galmchd92/Smart-Meter-using-ESP32-LoRa-Heltec/Layouts .pdf

# Layouts do circuito impresso

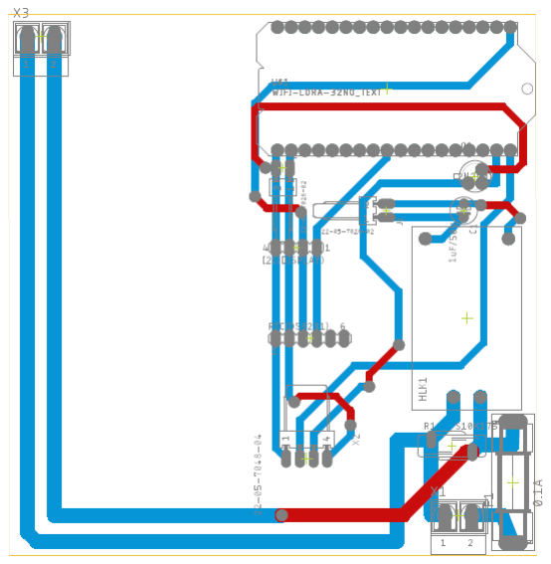
[picture p1: figure]

Figura 1 - Layout da placa feito no software Eagle

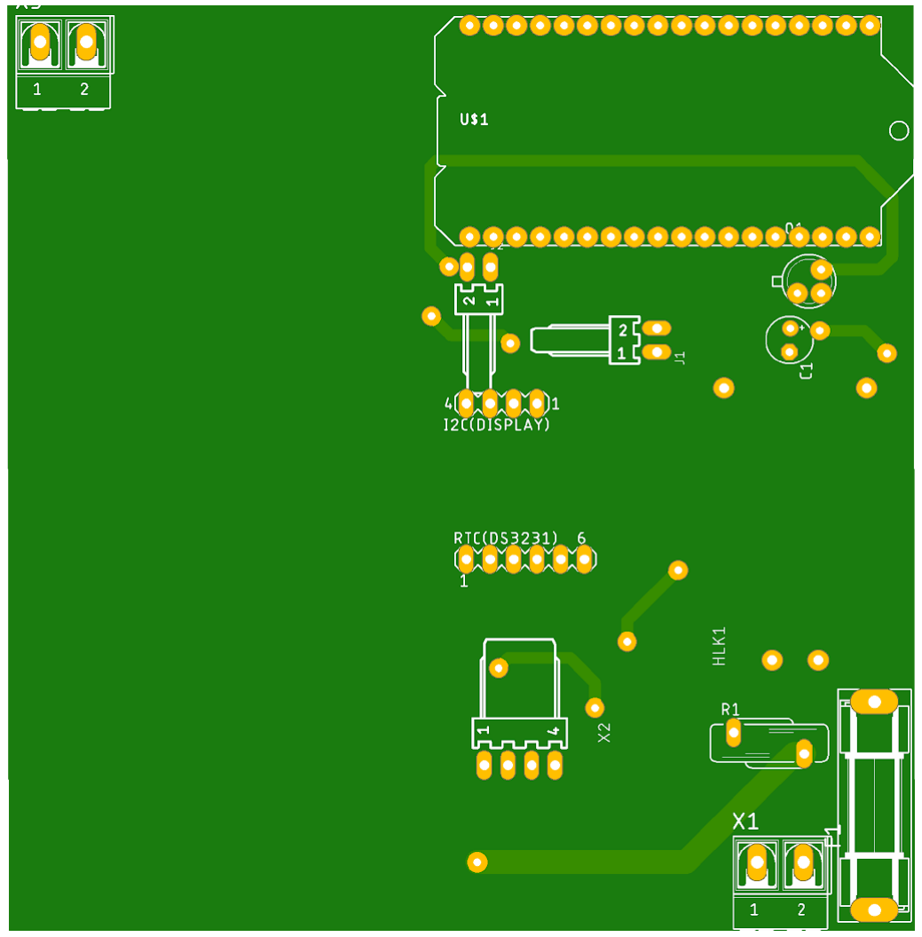
[picture p2: figure]

Figura 2 - Top

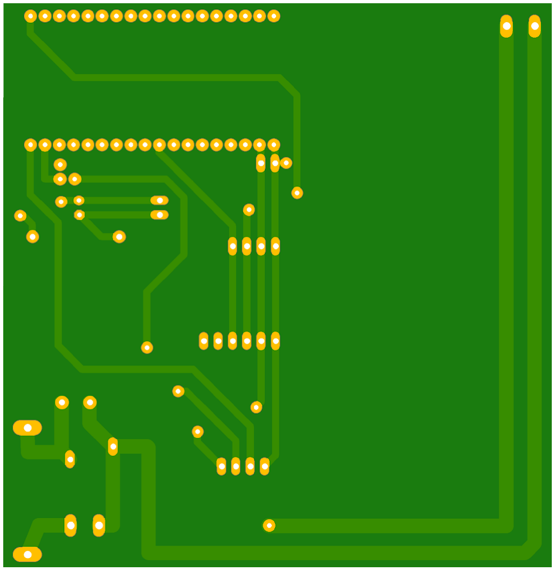
[picture p3: figure]

Figura 3 - Bottom

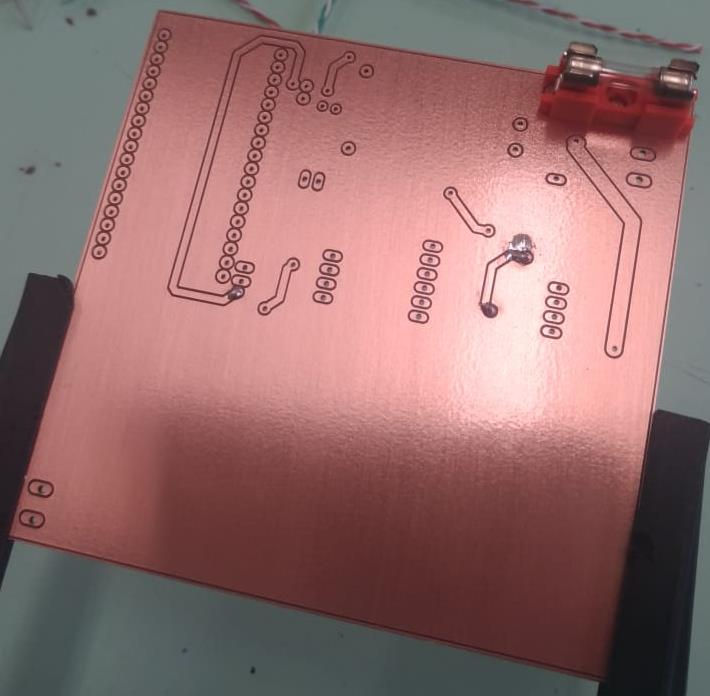
[picture p4: figure]

Figura 4 - Início do trabalho de soldagem

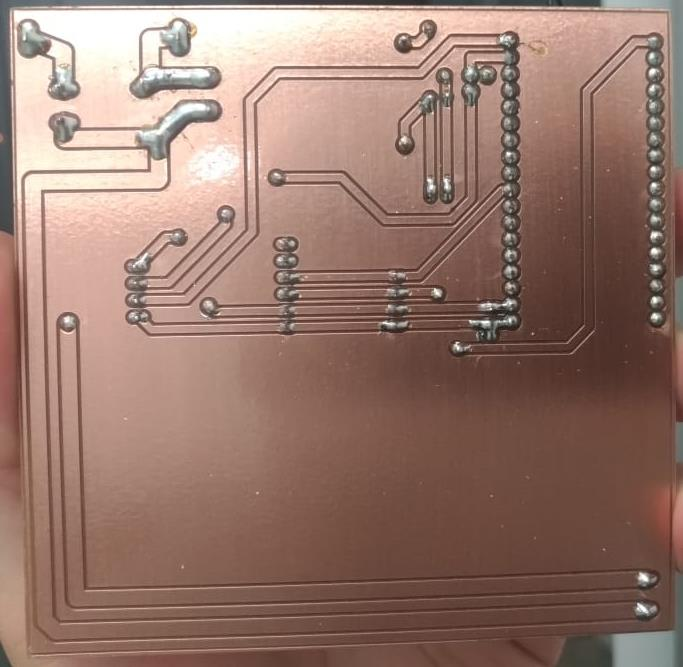
[picture p5: figure]

Figura 5 - Fim do trabalho de soldagem

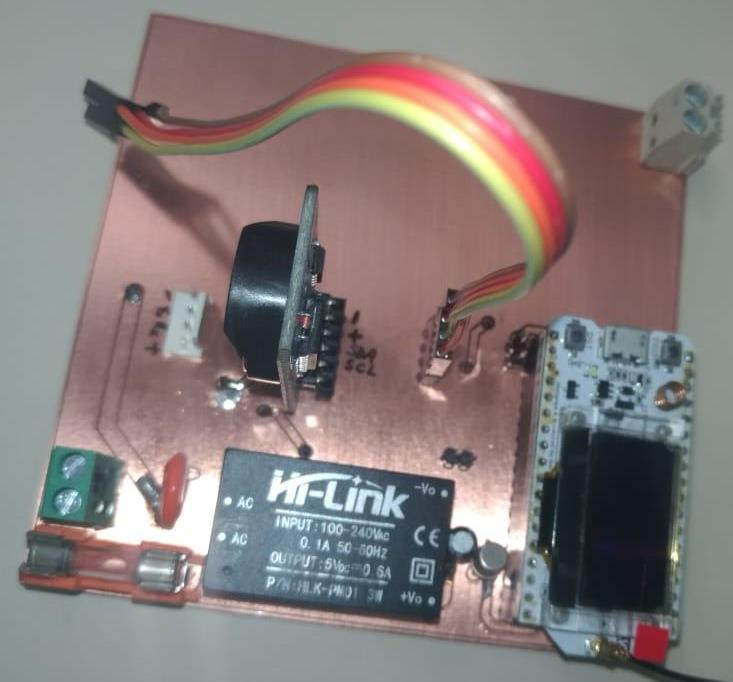
[picture p6: figure]

Figura 6 - Placa com seus devidos componente fixados

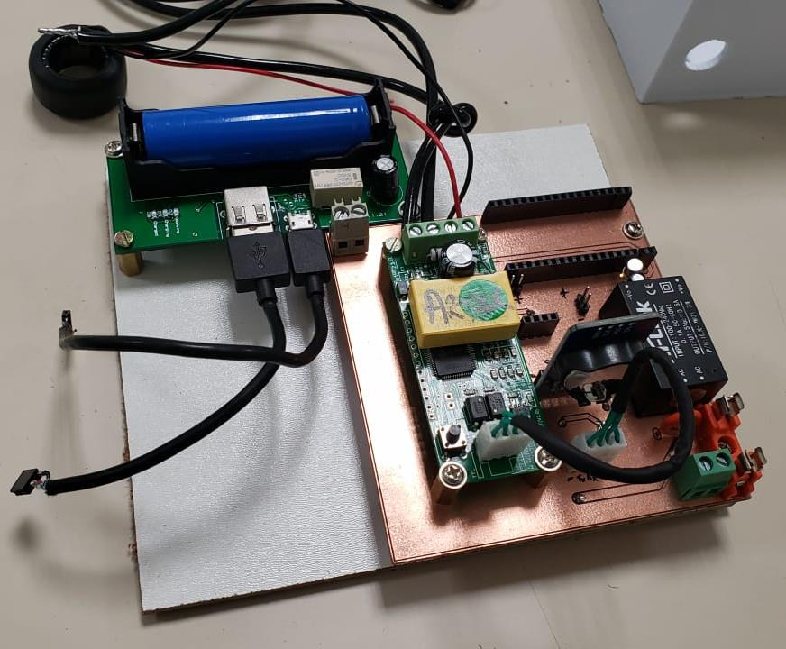
[picture p7: figure]

Figura 7 - Placa finalizada fixada numa placa de madeira com o nobreak
