galmchd92/Smart-Meter-using-ESP32-LoRa-Heltec/PDF Diagrama de Fiação.pdf

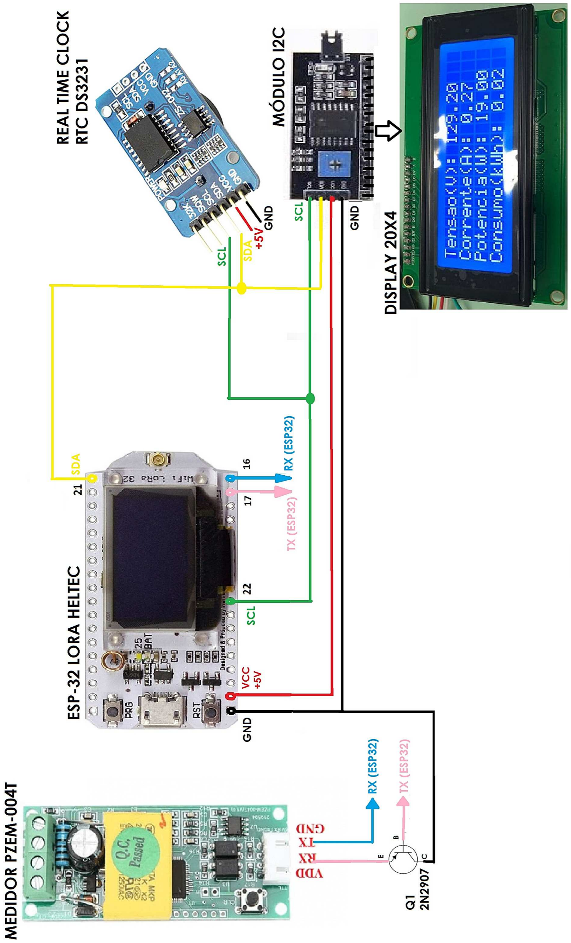
[picture p8: page 1]
