galmchd92/Smart-Meter-using-ESP32-LoRa-Heltec/Blynk App Tcc.jpg

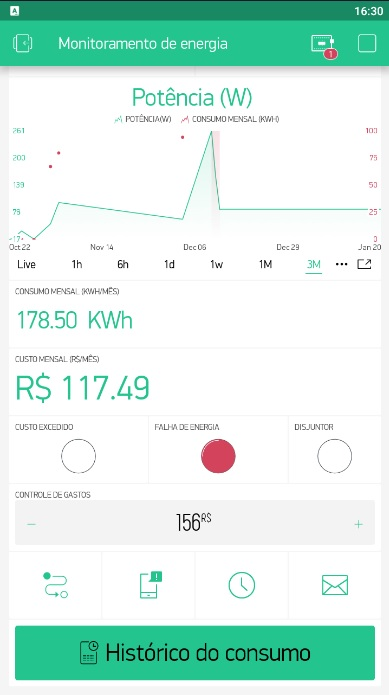
Blynk App Tcc.jpg
