galmchd92/Smart-Meter-using-ESP32-LoRa-Heltec/tcc_v5.stl

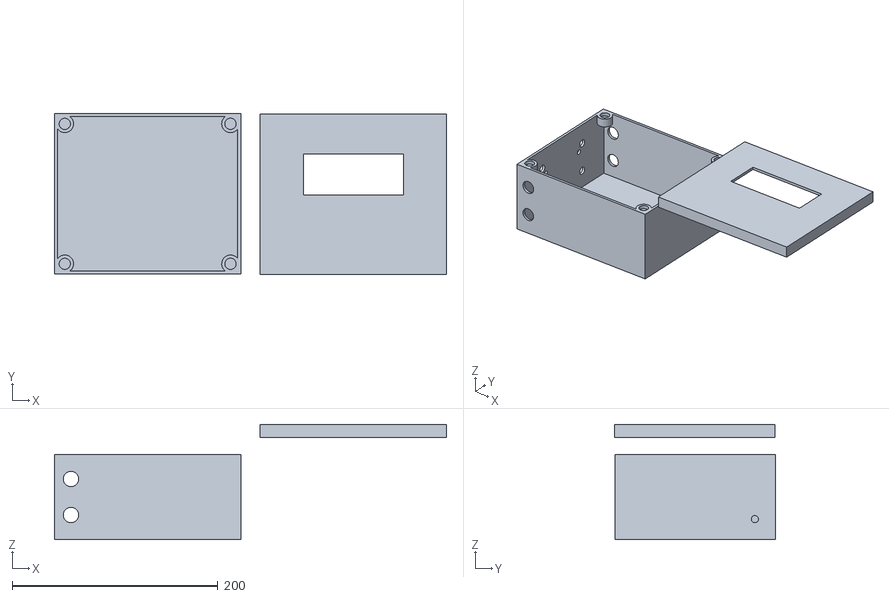
[picture p83: CAD file, 2020-01-04]
tcc_v5.stl
380.9 x 156.4 x 112.2
