galmchd92/Smart-Meter-using-ESP32-LoRa-Heltec/Esquemático software Eagle.pdf

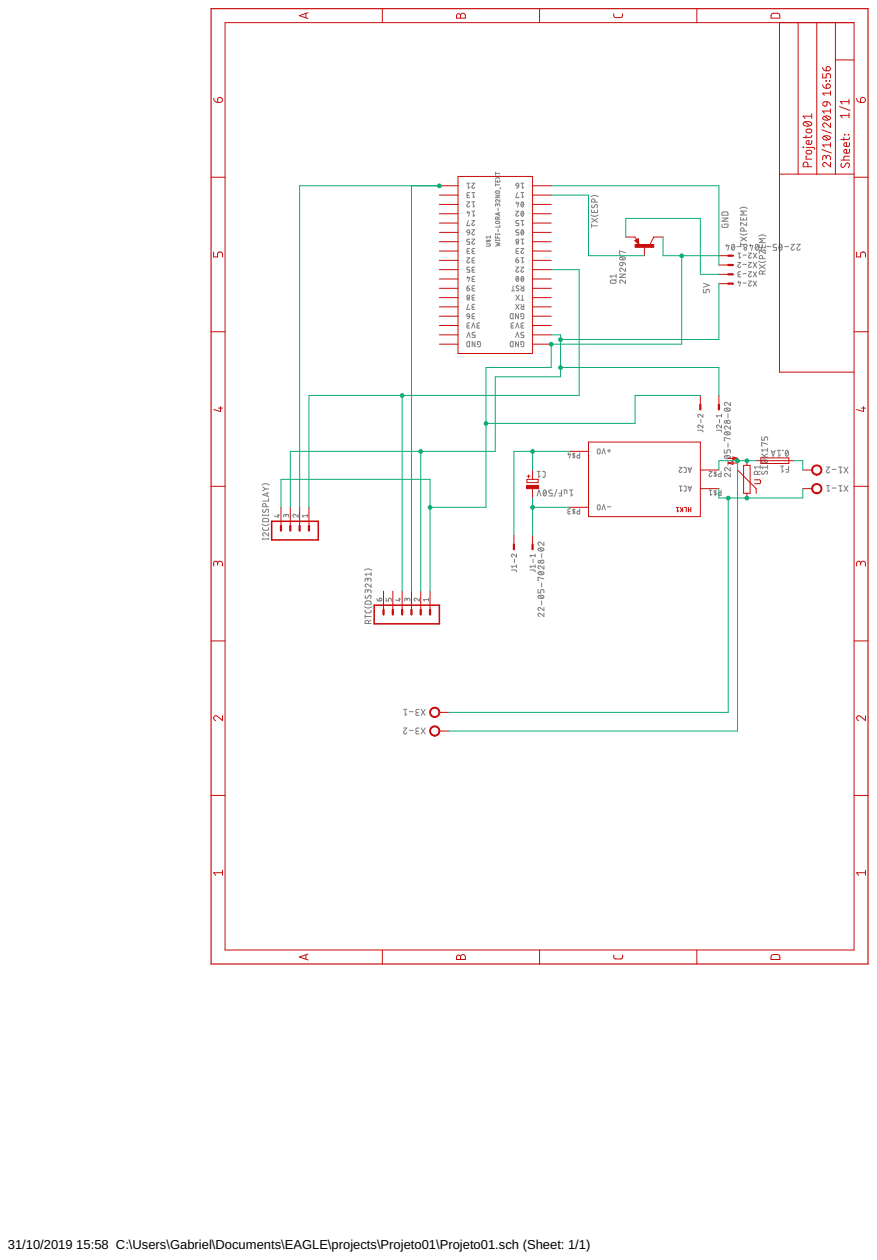
[picture p84: page 1]

31/10/2019 15:58 C:\Users\Gabriel\Documents\EAGLE\projects\Projeto01\Projeto01.sch (Sheet: 1/1)
